tmk/alps64/(threads)

Thread 1 (2017-11-28):

library not found in kicad

243750496, 2017-11-28:
library not found:
how to slove the issue?

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

tmk, 2017-11-28:
You can find here.
https://github.com/tmk/keyboard_parts.pretty

243750496, 2017-11-29:
why show me so many bugs , though i have already imported the lib you provided to me?

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

tmk, 2017-11-29:
you can ignore those if you are refering plate branch. schematic is not matter in that case.

Thread 2 (2020-06-12):

Bill of Materials?

lysol, 2020-06-12:
I've been going through the KiCad files, but a couple of items don't seem to have enough info to select parts: the tactile button and the LED. Is there a complete BOM that could be included in the project?

tmk, 2020-06-12:
They are Alps SKRP and ROHM SML012. I thnk you will find compatible components for them easily.

I never used BOM so far, btw. I'll add when I need that.
