tmk/alps64/(commit log)

2015-02-13 Add initial files
    [alps64.kicad_pcb, alps64.sch, matrix.sch]
2015-02-26 Change matrix
    [alps64.kicad_pcb, matrix.sch]
2015-02-27 Fix matrix net
    [alps64.kicad_pcb, alps64.sch]
2015-03-01 Change placement of diodes with KiCad scripting
    [alps64.kicad_pcb]
2015-03-02 Connect traces
    [alps64.kicad_pcb, matrix.sch]
2015-03-03 Retach almost OK
    [alps64.kicad_pcb]
2015-03-04 Change traces
    [alps64.kicad_pcb]
2015-03-05 Change reset button trace
    [alps64.kicad_pcb]
2015-03-05 Add infinity bottom row support
    [alps64.kicad_pcb, matrix.sch]
2015-03-07 Update date in schematics
    [alps64.sch, matrix.sch]
2015-03-07 Move PCB
    [alps64.kicad_pcb]
2015-03-07 Fix trace
    [alps64.kicad_pcb]
2015-03-13 Enlarge mouning holes
    [alps64.kicad_pcb]
2015-03-14 Cross check dimension with GH60 and Infinity
    [alps64.kicad_pcb]
2015-03-16 Add stepped capslock and debug LED
    [alps64.kicad_pcb]
2015-03-16 Fix keyswitch references like K21a -> K21_1
    [alps64.kicad_pcb]
2015-03-16 Fix LED1, R4 reference
    [alps64.kicad_pcb]
2015-03-16 Fix K40 footprint
    [alps64.kicad_pcb]
2015-03-16 Add net for LED1 and R4
    [alps64.kicad_pcb]
2015-03-16 Fix typo of footprint name
    [alps64.kicad_pcb]
2015-03-16 Update schematic, netlist and etc.
    [alps64.sch, matrix.sch]
2015-03-16 Move board
    [alps64.kicad_pcb]
2015-03-17 Enlarge mounting holes to 5mm wide and 2.8mm tall
    [alps64.kicad_pcb]
2015-03-17 Fix 5V line and GND copper fill
    [alps64.kicad_pcb]
2015-03-17 Fix silk
    [alps64.kicad_pcb]
2015-03-17 Fix C5 position
    [alps64.kicad_pcb]
2015-03-17 Add 104key space bar support
    [alps64.kicad_pcb, alps64.sch, matrix.sch]
2015-03-17 Fix USB connector keepout area
    [alps64.kicad_pcb]
2015-03-17 Make cutouts on both side with outline instead of oval pad
    [alps64.kicad_pcb]
2015-03-18 Fix outline of edge
    [alps64.kicad_pcb]
2015-03-18 Add solder mask for side cutouts
    [alps64.kicad_pcb]
2015-03-22 Change USB connector footprint
    [alps64.kicad_pcb]
2015-03-22 Change C1 C_3216 footprint
    [alps64.kicad_pcb]
2015-03-23 Fix pad of USB conn for paste layer
    [alps64.kicad_pcb]
2015-05-28 Fix ISO Enter key location
    Support three different locations
    - Rev.A: 1u center(Not exist?)
    - Alps: 1.5u center
    - Matias: 1.25u center
    [alps64.kicad_pcb, matrix.sch]
2015-10-09 Rev.C1 for Cherry 1.25u stepped Capslock
    [alps64.kicad_pcb]
2015-10-12 Move SMT diodes which interered with some of cases
    [alps64.kicad_pcb]
2015-10-13 Change LED footprint
    [alps64.kicad_pcb]
2015-10-14 Change soldermask of cutout on edge
    [alps64.kicad_pcb]
2016-04-16 Change vaules of C and R and add logo.
    [alps64.kicad_pcb, alps64.sch, matrix.sch]
2016-04-16 Fix X'tal foot print and ground connection
    [alps64.kicad_pcb]
2016-08-27 Enlarge TH land of USB connector
    [alps64.kicad_pcb]
2016-08-28 Change swithc silk marking
    [alps64.kicad_pcb]
2017-08-06 Fix USB footprint
    [alps64.kicad_pcb]
2017-08-07 Add breakout for unused pins
    [alps64.kicad_pcb]
2018-06-20 Update files for Rev.H(2018/01/28)
    [alps64.kicad_pcb, alps64.sch, matrix.sch]
2018-06-20 Remap symbols to rescue lib in schematics
    [alps64.sch, matrix.sch]
2018-09-04 Fix pad shape of C, R, D and QFP(Rev.I)
    [alps64.kicad_pcb]
2019-08-27 Remove resistor for HWB
    [alps64.kicad_pcb, alps64.sch, matrix.sch]
2019-09-06 Fix QFP32 footprint
    [alps64.kicad_pcb]
2020-02-12 Change connector to USB-C
    [alps64.kicad_pcb, alps64.sch, matrix.sch]
2022-11-05 Remove KBP V60 support holes
    [alps64.kicad_pcb]
2022-11-05 Change pad clearance for USB-C
    [alps64.kicad_pcb]
